NestOfGhosts/EInk-Weather-Display/BOM.csv

Item | Qty | Supplier | Cost/item | Total Cost | link
BME280 | 1 | Aliexpress | $6.74 | $6.74 | https://www.aliexpress.com/item/1005008809460489.html?mp=1
ESP32 Dev Board | 1 | Aliexpress | $4.00 | $4.00 | https://www.aliexpress.com/item/1005007059457759.html?mp=1
18650 Battery Holder Module | 1 | Aliexpress | $3.35 | $3.35 | https://www.aliexpress.com/item/1005006351276180.html?mp=1
18650 Battery | 1 | Aliexpress | $5.73 | $5.73 | https://www.aliexpress.com/item/1005012660806285.html?mp=1
E-Ink Display | 1 | Aliexpress | $11.09 | $11.09 | https://www.aliexpress.com/item/1005004644515880.html?mp=1
PCB | 1 | JLCPCB | $11.00 | $11.00 | https://jlcpcb.com
Estimated total shipping | 1 |  |  | $8.45
