NestOfGhosts/EInk-Weather-Display/Holder Files/halvedLife-Body.step

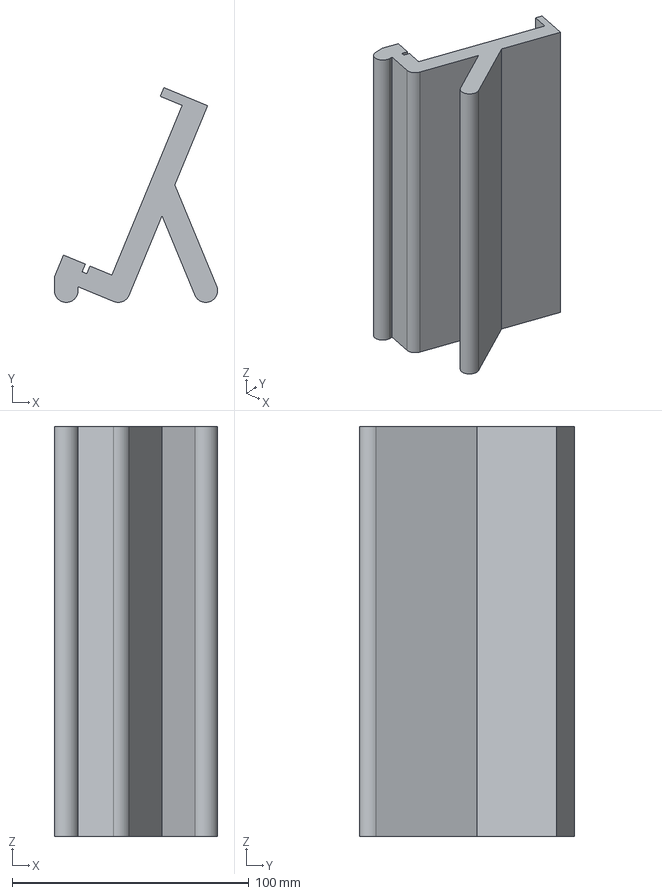
[picture p2: CAD file, 2026-11-06]
Holder Files/halvedLife-Body.step
68.9 x 90.7 x 173.0 mm
