NestOfGhosts/EInk-Weather-Display/(list of files, cad)

Other CAD files:
Holder Files/halvedLife.FCStd
Holder Files/halvedLife-Body.stl
