NestOfGhosts/EInk-Weather-Display/Pcb Files/shematic.pdf

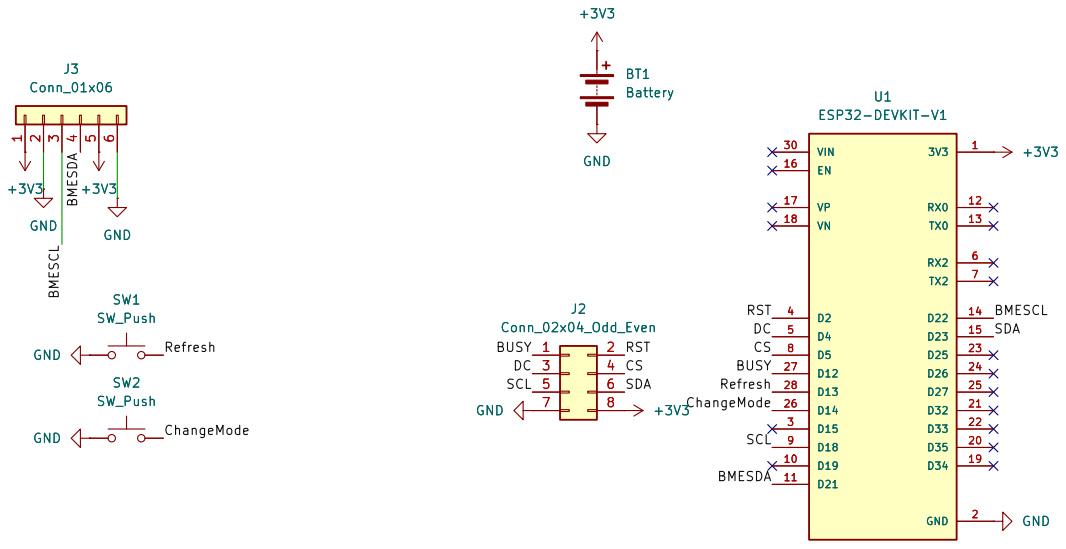
[picture p3: page 1]

Size: A4 | Rev:
KiCad E.D.A. 10.0.6 | Id: 1/1
