NestOfGhosts/EInk-Weather-Display/Pcb Files/weatstat.kicad_pcb

## KiCad design Pcb Files/weatstat.kicad_pcb (2026-11-07)

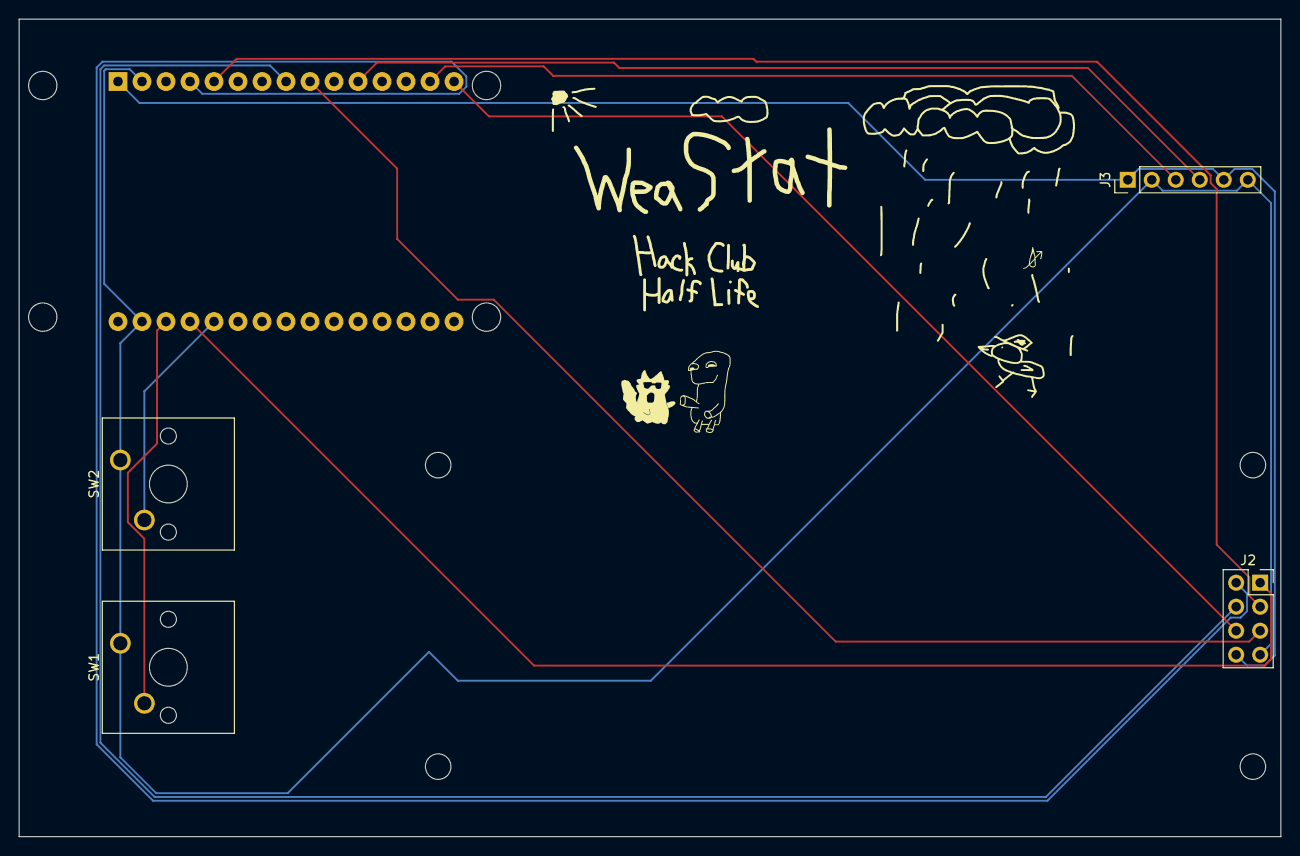
[picture p4: board weatstat.kicad_pcb from above]

Board: 2 copper layers, 133.5 x 86.5 mm, 5 parts (1 on the bottom side), 12 nets.

Parts:
J2: Conn_02x04_Odd_Even; PinHeader_2x04_P2.54mm_Vertical
J3: Conn_01x06; PinHeader_1x06_P2.54mm_Vertical
SW1, SW2: SW_Push; SW_Cherry_MX_1.00u_PCB
U1: ESP32-DEVKIT-V1; MODULE_ESP32_DEVKIT_V1

Connections:
+3V3: J2.8, J3.1, J3.5, U1.1 (3V3)
/BMESCL: J3.3, U1.14 (D22)
/BMESDA: J3.4, U1.11 (D21)
/BUSY: J2.1, U1.27 (D12)
/CS: J2.4, U1.8 (D5)
/ChangeMode: SW2.2, U1.26 (D14)
/DC: J2.3, U1.5 (D4)
/RST: J2.2, U1.4 (D2)
/Refresh: SW1.2, U1.28 (D13)
/SCL: J2.5, U1.9 (D18)
/SDA: J2.6, U1.15 (D23)
GND: J2.7, J3.2, J3.6, SW1.1, SW2.1, U1.2 (GND), U1.29 (GND)
