NestOfGhosts/EInk-Weather-Display/JOURNAL.md

# Weather Dashboard: devlog

<!-- Generated by Half Life from project jehb8l0g2qb5ii75xuxgdjyb. Edits here are overwritten on the next sync. -->
<!-- Generated: 2026-11-12T00:41:28.631Z -->

> [!NOTE]
> This devlog is mirrored from [Half Life](https://halflife.hackclub.com) ([open the project](https://halflife.hackclub.com/projects/jehb8l0g2qb5ii75xuxgdjyb)). Editing it here will not change the platform's copy, and the next sync overwrites this file.

> Thing that shows temperature of the room its in, and also shows weather outside via a free openweather api. My goal is battery life

| Week | Tier | Hours logged | Entries |
| --- | --- | --- | --- |
| Week 5 | Tier 2 | 17.58h | 10 |

## Contents

1. [2026-11-02: Started project. Started  making schematic for esp32 im using](#2026-11-02-started-project-started-making-schematic-for-esp3)
2. [2026-11-03: turns out that the footprint i was editing was the kicad default library. I decided to just reinstall kicad. to fix it](#2026-11-03-turns-out-that-the-footprint-i-was-editing-was-th)
3. [2026-11-04: Finished pcb, changed tier, and started readme.](#2026-11-04-finished-pcb-changed-tier-and-started-readme)
4. [2026-11-06: Work session](#2026-11-06-work-session)
5. [2026-11-07: figured out basic code plan and finished readme. Also had to reroute a bit bc i did display backwards](#2026-11-07-figured-out-basic-code-plan-and-finished-readme-a)
6. [2026-11-07: just finalized code planning.](#2026-11-07-just-finalized-code-planning)
7. [2026-11-07: Before the appended timelapse, I had to setup platformIO on my laptop, but hackatime doesnt track that and i dont have lookout on my laptop soooo.](#2026-11-07-before-the-appended-timelapse-i-had-to-setup-plat)
8. [2026-11-08: Continued coding, but on the pc (no vscode on pc)](#2026-11-08-continued-coding-but-on-the-pc-no-vscode-on-pc)
9. [2026-11-11: Coded firmware. This is tracking for time spent outside of vscode](#2026-11-11-coded-firmware-this-is-tracking-for-time-spent-ou)
10. [2026-11-11: Converting photopea prototype to lopaka](#2026-11-11-converting-photopea-prototype-to-lopaka)

## Design

### 2026-11-02: Started project. Started  making schematic for esp32 im using

**1.55h**

Started project. Started  making schematic for esp32 im using

[Timelapse](https://lookout.hackclub.com/api/media/18d4701b-b7c2-46e3-96a6-38bd7384858b/video.mp4)

### 2026-11-03: turns out that the footprint i was editing was the kicad default library. I decided to just reinstall kicad. to fix it

**2.22h**

turns out that the footprint i was editing was the kicad default library. I decided to just reinstall kicad. to fix it

I changed the plan from breadboard to a custom pcb with generic headers because it was ✨impossible✨ to find the dimensions of aliexpress parts

[Timelapse](https://lookout.hackclub.com/api/media/67f5cf80-92d2-49bc-9132-ab53cc5b4e0f/video.mp4)

### 2026-11-04: Finished pcb, changed tier, and started readme.

**3.52h**

Finished pcb, changed tier, and started readme.

ALSO THE ROUTING WAS SO DAMN HARD EITHER CAUSE THE DEV BOARDS PINS ARE REALLY CLOSE OR THE FOOTPRINT MAKER MADE MASSIVE PADS AND I COULDNT ROUTE BETWEEN THE PADSSSSSSSS.

i figured it out tho

Major time blocks:
- The routing thing (seen above)
- Eink display doesnt have a footprint, had to rickety my own (mostly for mounting holes). Specially bad bc the blueprint for it doesnt include size of mounting holes, so had to guestimate it.
- Draw silkscreen. Deadass spent half an hour on a dumpster fire.
- Not understanding I2c and spi protocols, and subsequently the optimal wiring for those protocols on the specific model of esp im using

[Timelapse](https://lookout.hackclub.com/api/media/ab253eab-6916-4b51-80e0-6cfc3def7fb4/video.mp4)

### 2026-11-06: Work session

**1.07h**

[Timelapse](https://lookout.hackclub.com/api/media/30c2d98d-3806-476b-824c-5567948be3e8/video.mp4)

### 2026-11-07: figured out basic code plan and finished readme. Also had to reroute a bit bc i did display backwards

**2.33h**

figured out basic code plan and finished readme. Also had to reroute a bit bc i did display backwards

[Timelapse](https://lookout.hackclub.com/api/media/84dc4c19-b900-44d7-853e-0670704a3608/video.mp4)

### 2026-11-07: just finalized code planning.

**0.12h**

just finalized code planning.

[Timelapse](https://lookout.hackclub.com/api/media/fddef280-0be5-4cb3-8857-079132cdb7aa/video.mp4)

### 2026-11-07: Before the appended timelapse, I had to setup platformIO on my laptop, but hackatime doesnt track that and i dont have lookout on my laptop soooo.

**2.05h**

Before the appended timelapse, I had to setup platformIO on my laptop, but hackatime doesnt track that and i dont have lookout on my laptop soooo.

End of the timelapse i go back to coding on my laptop, which is tracked by hackatime

[Timelapse](https://lookout.hackclub.com/api/media/a9ba0ad1-015a-41e4-825d-be2d8b1a24b1/video.mp4)

### 2026-11-08: Continued coding, but on the pc (no vscode on pc)

**1.72h**

Continued coding, but on the pc (no vscode on pc)

[Timelapse](https://lookout.hackclub.com/api/media/14ffd309-2214-438d-a614-d93ffd540064/video.mp4)

### 2026-11-11: Coded firmware. This is tracking for time spent outside of vscode

**2.5h**

Coded firmware. This is tracking for time spent outside of vscode
Additional time is time spent finding the specific api url



(end result)

Drafting up screen prototype, started by drawing symbols:









Final composited, art is hard for me

### 2026-11-11: Converting photopea prototype to lopaka

**0.5h**

Converting photopea prototype to lopaka




(pictures of bitmap i uploaded)

Uhhhh i need 200 character minimum. So the lopaka code is a static image, so i need to code edge alignment and usage of the variables. I really like snow, so the "snow!" label appears when... theress some snow...
